CapnBry/AlarmHomie/eagle/AlarmScrape.brd

## EAGLE design eagle/AlarmScrape.brd (2016-05-08)

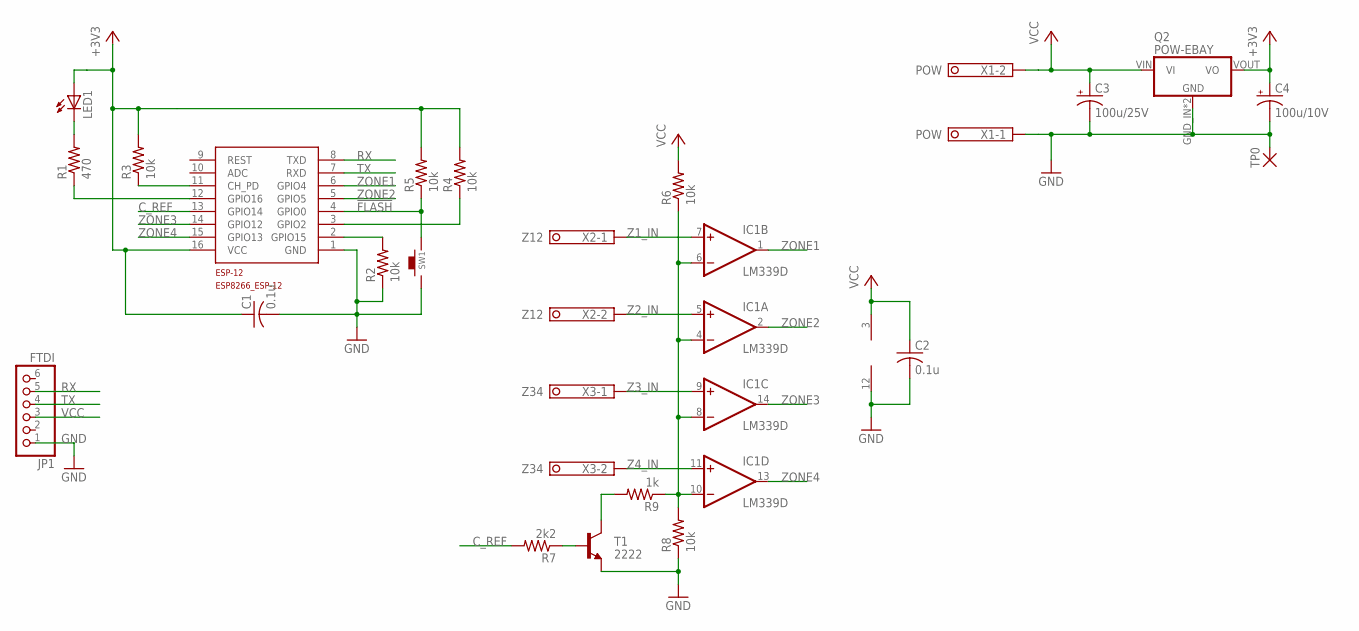
[picture p1: schematic AlarmScrape.sch]

Parts:
C1, C2: 0.1u; C0805
C3: 100u/25V; E2,5-6
C4: 100u/10V; E2,5-6
ESP-12: ESP8266_ESP-12; ESP8266-ESP12
IC1: LM339D; SO14
JP1: FTDI; 1X06
LED1: LEDCHIPLED_0805; CHIPLED_0805
Q2: POW-EBAY; POW-BUCK-EBAY
R1: 470; R0805
R2, R3, R4, R5, R6, R8: 10k; R0805
R7: 2k2; R0805
R9: 1k; R0805
SW1: FLASH; TACT-4X3
T1: 2222; SOT23-3
TP0: THROUGH-HOLE; PAD-032
X1: POW; 1751248
X2: Z12; 1751248
X3: Z34; 1751248

Connections:
!FLASH: ESP-12.4 (GPIO0), R5.1, SW1.P1
+3V3: C1.1, C4.+, ESP-12.16 (VCC), LED1.A, Q2.VOUT (VO), R3.2, R4.2, R5.2
C_REF: ESP-12.13 (GPIO14), R7.2
GND: C1.2, C2.2, C3.-, C4.-, ESP-12.1 (GND), IC1.12 (GND), JP1.1, Q2.GND_IN (GND), Q2.GND_OUT (GND), R2.1, R8.1, SW1.P0, T1.2 (E), TP0.P, X1.1
unnamed: ESP-12.12 (GPIO16), R1.1
unnamed: ESP-12.11 (CH_PD), R3.1
unnamed: ESP-12.2 (GPIO15), R2.2
unnamed: LED1.C, R1.2
unnamed: ESP-12.3 (GPIO2), R4.1
unnamed: R7.1, T1.1 (B)
unnamed: IC1.4 (-IN), IC1.6 (-IN), IC1.8 (-IN), IC1.10 (-IN), R6.1, R8.2, R9.1
unnamed: R9.2, T1.3 (C)
RX: ESP-12.8 (TXD), JP1.5
TX: ESP-12.7 (RXD), JP1.4
VCC: C2.1, C3.+, IC1.3 (V+), JP1.3, Q2.VIN (VI), R6.2, X1.2
Z1_IN: IC1.7 (+IN), X2.1
Z2_IN: IC1.5 (+IN), X2.2
Z3_IN: IC1.9 (+IN), X3.1
Z4_IN: IC1.11 (+IN), X3.2
ZONE1: ESP-12.6 (GPIO4), IC1.1 (OUT)
ZONE2: ESP-12.5 (GPIO5), IC1.2 (OUT)
ZONE3: ESP-12.14 (GPIO12), IC1.14 (OUT)
ZONE4: ESP-12.15 (GPIO13), IC1.13 (OUT)

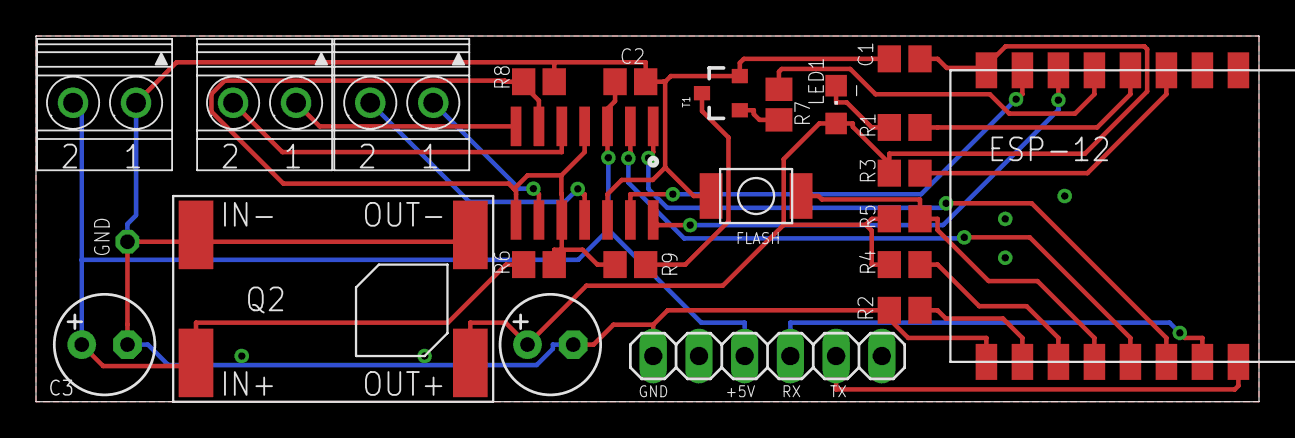
[picture p2: board AlarmScrape.brd from above]

Board: 2 copper layers, 67.9 x 20.3 mm, 24 parts (0 on the bottom side), 23 nets.
